DhairyaSanathara/ENR206-Industrial-Machine-Safety-Monitor/docs/README.md

# Documentation

## Every component

- [Arduino Uno](components/arduino-uno.md)
- [SMPS and power distribution](components/smps-power-supply.md)
- [Relay module](components/relay-module.md)
- [L298N motor driver and PWM](components/l298n-motor-driver.md)
- [12 V DC gear motor](components/dc-gear-motor.md)
- [HC-SR04 ultrasonic sensor](components/hc-sr04-ultrasonic.md)
- [DHT11 / DHT22](components/dht11-dht22.md)
- [MPU6050](components/mpu6050.md)
- [I2C bus and 16×2 LCD](components/i2c-bus-and-lcd.md)
- [Buttons, LEDs and buzzer](components/buttons-leds-buzzer.md)

## The system

- [Wiring](wiring.md)
- [Firmware design](firmware.md)
- [Serial protocol](serial-protocol.md)
- [Calculations](calculations.md)
- [Testing and troubleshooting](testing.md)
- [Limitations and future work](limitations-and-future-work.md)
- [Web dashboard](../web/README.md)
