DhairyaSanathara/ENR206-Industrial-Machine-Safety-Monitor/(commit log)

2026-11-03 Add Arduino firmware and hardware test sketches
    Main program: state machine with interrupt E-stop, watchdog, learned
    vibration limits, temperature rise rate and stall detection.
    Test sketches for bring-up of each part.
    [dht_test.ino, hello_lcd.ino, lcd_letters.ino, lcd_test.ino, machine_safety_v2.ino, motor_speed.ino, mpu_test.ino, power_check.ino]
2026-11-03 Add documentation for every component and the system design
    How each part works, wiring, firmware design, serial protocol,
    calculations, testing and limitations.
